Addy0265/SmartSteer/README.md

# SmartSteer

Codes and data for SmartSteer - a smart frontal attachment for wheelchairs
