Addy0265/SmartSteer/Report/asd.jpg

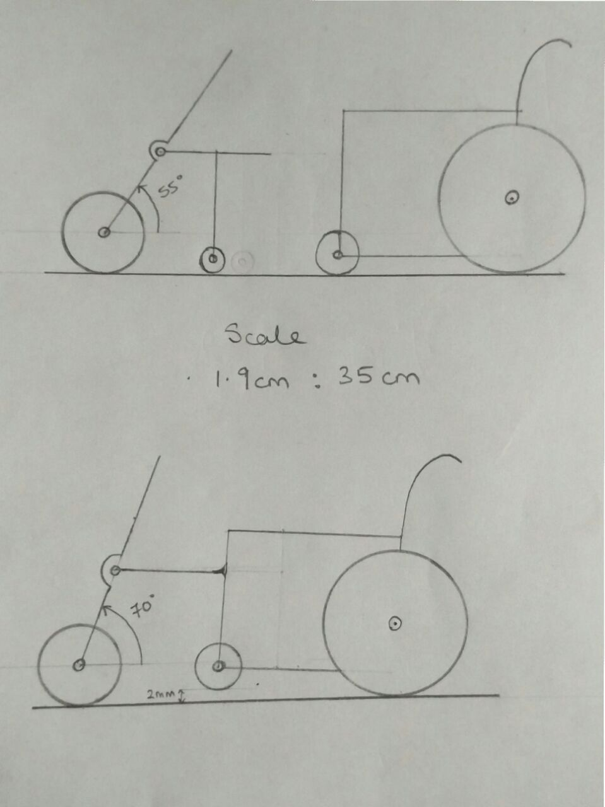
Report/asd.jpg
