Addy0265/SmartSteer/Report/drawing.jpg

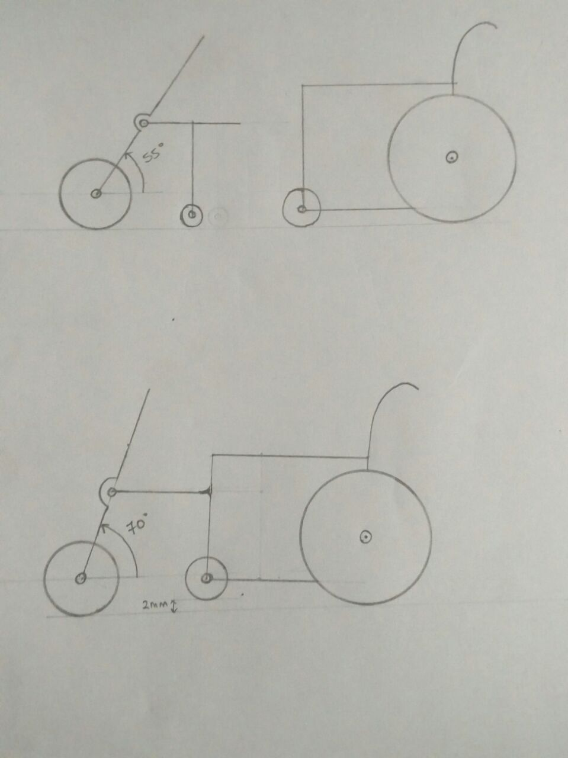
Report/drawing.jpg
